HHCIB/Displegory/README.md

# Displegory

Raspberry Pi departure board for Stockholm public transport (SL): live commuter rail, bus and metro departures on a 7.5" e-Paper display.

| Path | Contents |
|---|---|
| [Firmware/](Firmware/) | Python code. See [Firmware/README.md](Firmware/README.md). |
| [Firmware/setup/](Firmware/setup/) | Raspberry Pi setup and configuration. |
| [STL/](STL/) | Enclosure frames (STL) and PCB designs (Fusion 360). |
