HHCIB/Displegory/kf350-3-5mm-pitch-screw-terminal-block-2p-3p-1.snapshot.5/KF350-v1.png

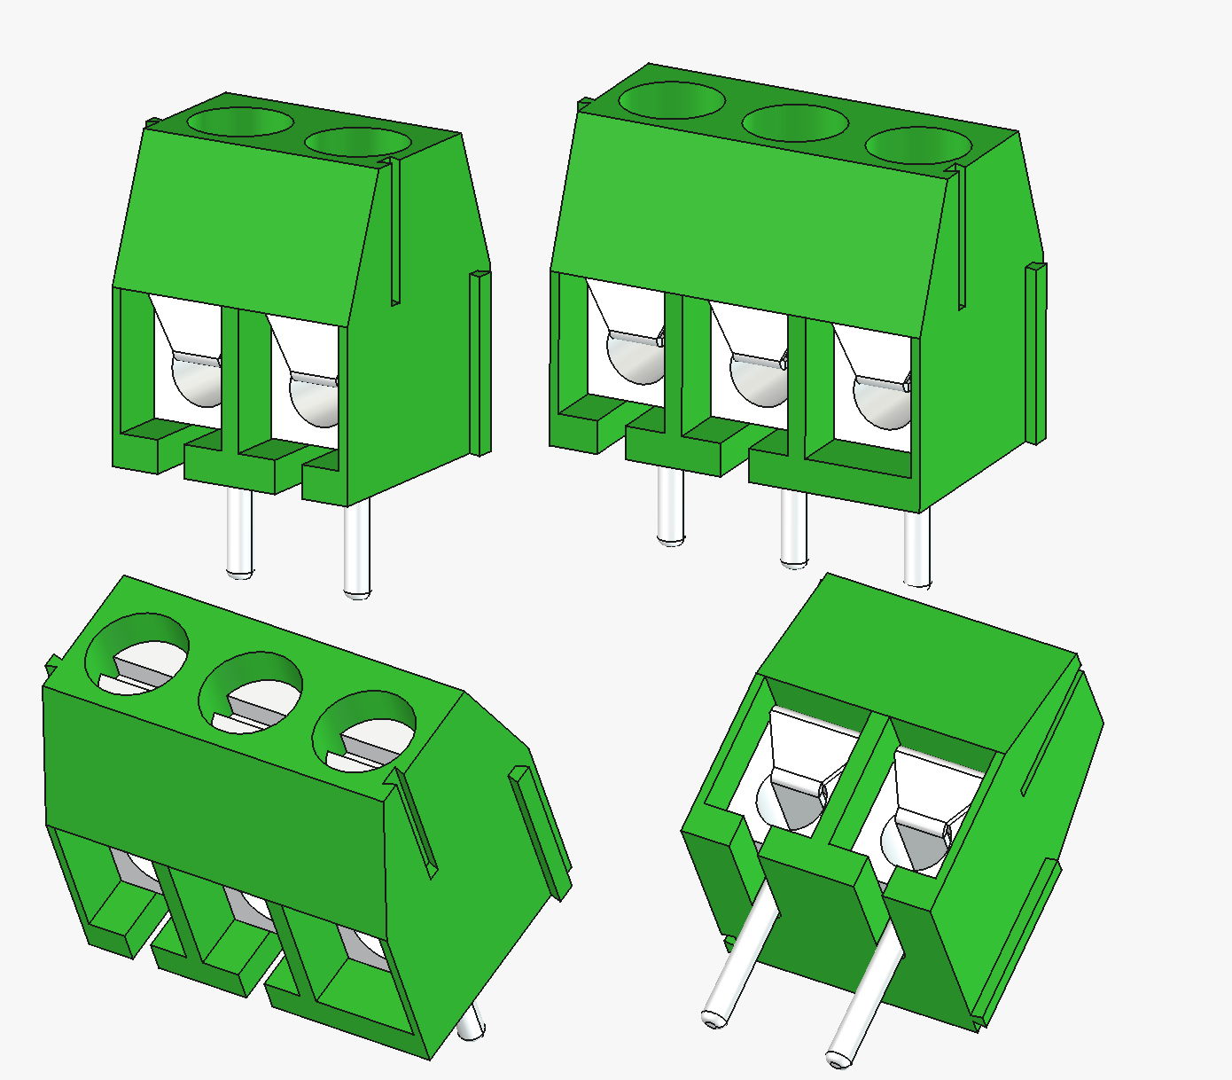
kf350-3-5mm-pitch-screw-terminal-block-2p-3p-1.snapshot.5/KF350-v1.png
