HHCIB/Displegory/STL/V3_Frame.stl

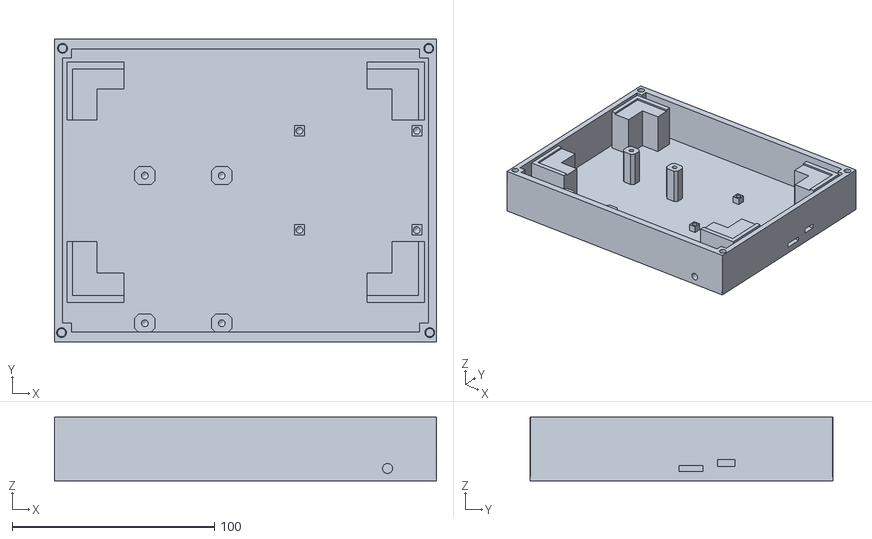
[picture p4: CAD file, 2026-11-08]
STL/V3_Frame.stl
188.8 x 150.0 x 31.5
