HHCIB/Displegory/kf350-3-5mm-pitch-screw-terminal-block-2p-3p-1.snapshot.5/KF350-2p.step

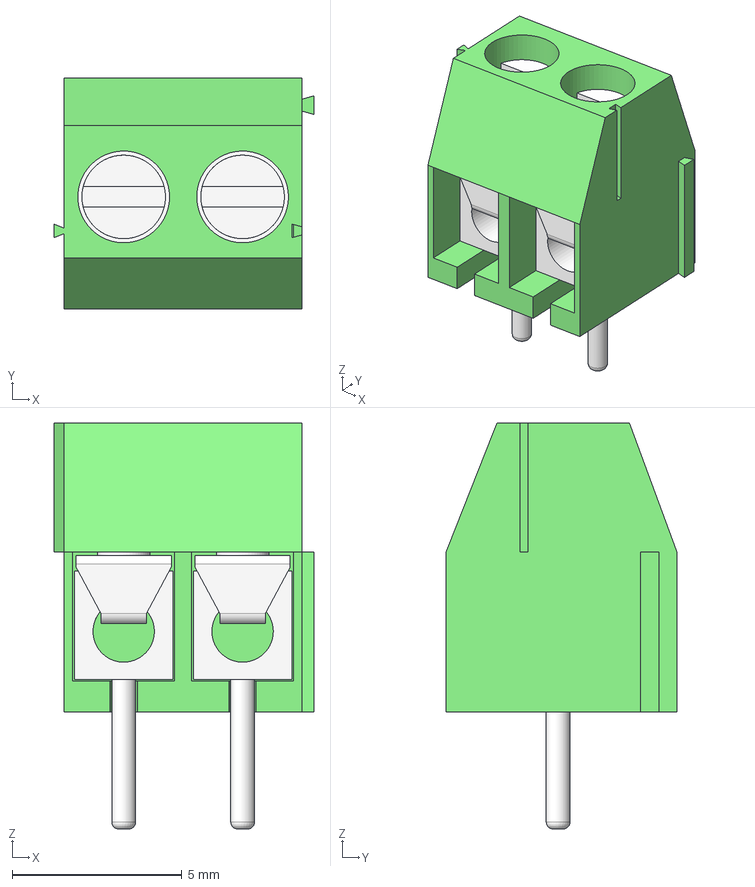
[picture p6: CAD file, 2026-11-08]
kf350-3-5mm-pitch-screw-terminal-block-2p-3p-1.snapshot.5/KF350-2p.step
7.65 x 6.80 x 11.9 mm
Corps
Conn_1
Conn_2
blade_1
blade_2
Vis_1
Vis_001
