HHCIB/Displegory/STL/V1_Frame.stl

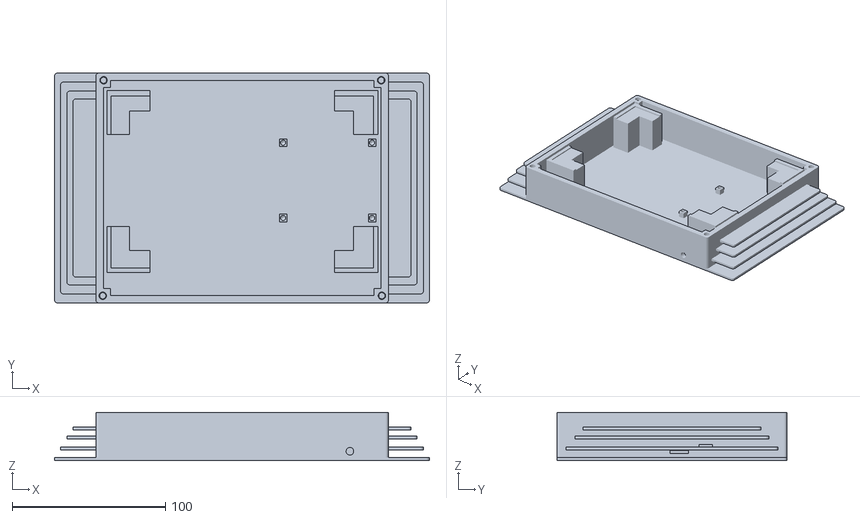
[picture p7: CAD file, 2026-11-08, an earlier design]
STL/V1_Frame.stl
244.5 x 150.0 x 31.5
