HHCIB/Displegory/(list of files, cad)

Other CAD files:
STL/V2_frame.stl
STL/PCB - DISPLAY - 45x80_pcb_display.f3d
STL/PCB - navigation.f3d
